SyrNitram/recon-ground-drone/images/app-control.gif

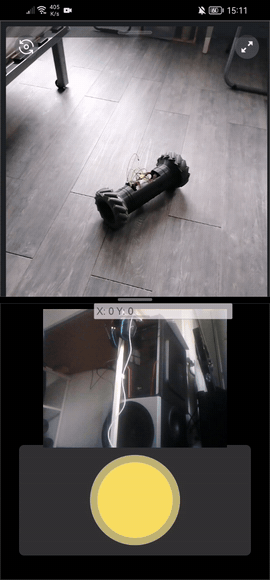
images/app-control.gif
