SyrNitram/recon-ground-drone/images/hero-lit.jpg

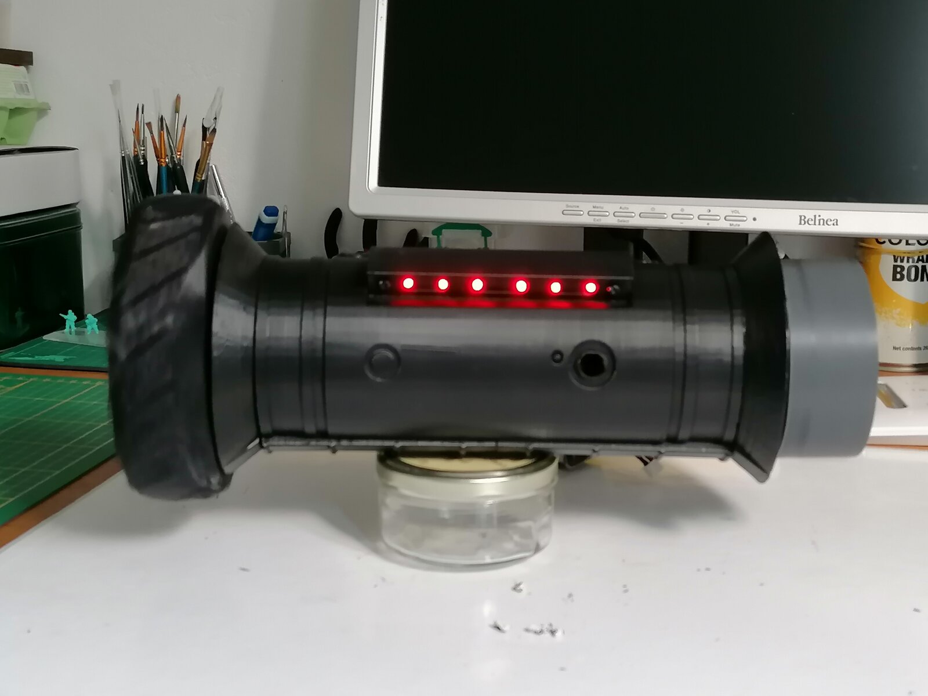
images/hero-lit.jpg
