SyrNitram/recon-ground-drone/hardware/BOM.xlsx

Sheet: BOM_bat+ch
Mecanique | Réference | Prix unitaire | Qté | Prix total | Prix commande | Delais de livraison | Liens
PLA | ICE Filaments PLA filament, 1.75mm, 0.75 kg Brave Black | 16.94 | 2 | 33.88 | 33.88 | 3 | https://amzn.eu/d/2PTAt4H
TPU | SUNLU TPU Filament 1.75 mm, 0.5kg Black | 19.99 | 1 | 19.99 | 19.99 | 3 | https://amzn.eu/d/gMaCLZG
kit vis | 230 Pièces M2 Vis à Tête Hexagonale en Acier Inoxydable | 12 | 0.5 | 6 | 12 | 4 | https://amzn.eu/d/2nECZO1
roulement à bille | 10pcs Roulements à Billes Roulements (8x16x5mm) | 8.99 | 0.2 | 1.798 | 8.99 | 3 | https://amzn.eu/d/efW1nxD | https://www.aliexpress.com/item/1005004120192357.html
ressort | 20pcs 0.4mm 3mm 50mm ressort | 2.02 | 0.05 | 0.101 | 2.02 | 60 | https://www.aliexpress.com/item/1005001408323096.html?curPageLogUid=bRA3kIthAXiv
Total robot Meca |  |  |  | 61.769
Total commande Meca |  |  |  |  | 76.88
Electronique
Moteurs | Moto-reducteur 12v 130RPM | 8.16 | 2 | 16.32 | 16.32 | 30 | https://fr.aliexpress.com/item/1005003500998134.html
L298N | 5 Pièces L298N Carte contrôleur | 13.79 | 0.2 | 2.758 | 13.79 | 3 | https://amzn.eu/d/0nnKbMM
ESP32-cam | ESP32 Carte de Développement +OV2640 + antenne 2,4GHz | 14.96 | 1 | 14.96 | 14.96 | 3 | https://amzn.eu/d/3P0Oj14
GPIO-expander | ZkeeShop 6Pcs PCF8574 IO Expansion Board I2C Interface | 11.99 | 0.1666666667 | 1.998333333 | 11.99 | 4 | https://amzn.eu/d/fPdxQ3Y
Led rouge ou bleu | 50pcs F3 3MM Round Clear / Fog Two Color Common Anode | 2.28 | 0.12 | 0.2736 | 2.28 | 5 | https://www.aliexpress.com/item/1005003764996533.html?spm=a2g0o.cart.0.0.213438daeBNRyS&mp=1
kit Gaine thermo + cable+connecteur+resistance | Made in Maison | 15 | 1 | 15 | 15 | na
Batterie | TATTU 1300 mAh 11.1 V 75C 3S1P LiPo XT60 | 16.99 | 1 | 16.99 | 16.99 | 15 | https://amzn.eu/d/0NoKHRE
Chargeur | ICQUANZX Chargeur d'équilibre de Batterie au Lithium, B3 Pro 2S-3S | 11.99 | 1 | 11.99 | 11.99 | 4 | https://amzn.eu/d/6dby1jH
Bouton | 10Pcs Latching Self-locking Push button | 2.45 | 0.1 | 0.245 | 2.45 | 3 | https://www.aliexpress.com/item/32691250472.html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
Total robot Elec |  |  |  | 80.53493333
Total commande Elec |  |  |  |  | 105.77
Total robot |  |  |  | 142.3039333
Total commande |  |  |  |  | 182.65

Sheet: BOM_bat
Mecanique | Réference | Prix unitaire | Qté | Prix total | Prix commande | Delais de livraison | Liens
PLA | ICE Filaments PLA filament, 1.75mm, 0.75 kg Brave Black | 16.94 | 2 | 33.88 | 33.88 | 3 | https://amzn.eu/d/2PTAt4H
TPU | SUNLU TPU Filament 1.75 mm, 0.5kg Black | 19.99 | 1 | 19.99 | 19.99 | 3 | https://amzn.eu/d/gMaCLZG
kit vis | 230 Pièces M2 Vis à Tête Hexagonale en Acier Inoxydable | 12 | 0.5 | 6 | 12 | 4 | https://amzn.eu/d/2nECZO1
roulement à bille | 10pcs Roulements à Billes Roulements 6001-2RS (12x28x8mm) | 21.39 | 0.2 | 4.278 | 21.39 | 3 | https://amzn.eu/d/4jeZSVb
Total robot Meca |  |  |  | 64.148
Total commande Meca |  |  |  |  | 87.26
Electronique
Moteurs | Moto-reducteur 12v 130RPM | 8.16 | 2 | 16.32 | 16.32 | 30 | https://fr.aliexpress.com/item/1005003500998134.html
L298N | 5 Pièces L298N Carte contrôleur | 13.79 | 0.2 | 2.758 | 13.79 | 3 | https://amzn.eu/d/0nnKbMM
ESP32-cam | ESP32 Carte de Développement +OV2640 + antenne 2,4GHz | 14.96 | 1 | 14.96 | 14.96 | 3 | https://amzn.eu/d/3P0Oj14
GPIO-expander | ZkeeShop 6Pcs PCF8574 IO Expansion Board I2C Interface | 11.99 | 0.1666666667 | 1.998333333 | 11.99 | 4 | https://amzn.eu/d/fPdxQ3Y
Servo-moteur | 5 Pièces Longruner SG90 Mini Servo Moteur 9g | 15.99 | 0.2 | 3.198 | 15.99 | 3 | https://amzn.eu/d/j3UOdCJ
Led rouge ou bleu | AUKENIEN 500 Pièces 3MM Diode LED Kit D'assortiment (200 utiles) | 9.99 | 0.03 | 0.2997 | 9.99 | 5 | https://amzn.eu/d/gkMQvUh
Resitance | Résistances carbone 150 Ohms 1/4 Watts +/- 5% (50) | 3.7 | 0.12 | 0.444 | 3.7 | 5 | https://amzn.eu/d/aoKDxQv
kit Gaine thermo + cable+connecteur | Made in Maison | 15 | 1 | 15 | 15 | na
Batterie | TATTU 1550 mAh 11.1 V 45C 3S1P LiPo XT60 | 15.99 | 1 | 15.99 | 15.99 | 15 | https://amzn.eu/d/iXAa5Lm
Chargeur | ICQUANZX Chargeur d'équilibre de Batterie au Lithium, B3 Pro 2S-3S | 11.99 | 0 | 0 | 0 | 4 | https://amzn.eu/d/6dby1jH
alarme lipo | 5Pack Testeur de batterie basse tension Youmile 1-8S | 16.29 | 0.2 | 3.258 | 16.29 | 3 | https://amzn.eu/d/8aOpBTQ
Total robot Elec |  |  |  | 74.22603333
Total commande Elec |  |  |  |  | 134.02
Total robot |  |  |  | 138.3740333
Total commande |  |  |  |  | 221.28

Sheet: BOM
Mecanique | Réference | Prix unitaire | Qté | Prix total | Prix commande | Delais de livraison | Liens
PLA | ICE Filaments PLA filament, 1.75mm, 0.75 kg Brave Black | 16.94 | 2 | 33.88 | 33.88 | 3 | https://amzn.eu/d/2PTAt4H
TPU | SUNLU TPU Filament 1.75 mm, 0.5kg Black | 19.99 | 1 | 19.99 | 19.99 | 3 | https://amzn.eu/d/gMaCLZG
kit vis | 230 Pièces M2 Vis à Tête Hexagonale en Acier Inoxydable | 12 | 0.5 | 6 | 12 | 4 | https://amzn.eu/d/2nECZO1
roulement à bille | 10pcs Roulements à Billes Roulements 6001-2RS (12x28x8mm) | 21.39 | 0.2 | 4.278 | 21.39 | 3 | https://amzn.eu/d/4jeZSVb
Total robot Meca |  |  |  | 64.148
Total commande Meca |  |  |  |  | 87.26
Electronique
Moteurs | Moto-reducteur 12v 130RPM | 8.16 | 2 | 16.32 | 16.32 | 30 | https://fr.aliexpress.com/item/1005003500998134.html
L298N | 5 Pièces L298N Carte contrôleur | 13.79 | 0.2 | 2.758 | 13.79 | 3 | https://amzn.eu/d/0nnKbMM
ESP32-cam | ESP32 Carte de Développement +OV2640 + antenne 2,4GHz | 14.96 | 1 | 14.96 | 14.96 | 3 | https://amzn.eu/d/3P0Oj14
GPIO-expander | ZkeeShop 6Pcs PCF8574 IO Expansion Board I2C Interface | 11.99 | 0.1666666667 | 1.998333333 | 11.99 | 4 | https://amzn.eu/d/fPdxQ3Y
Servo-moteur | 5 Pièces Longruner SG90 Mini Servo Moteur 9g | 15.99 | 0.2 | 3.198 | 15.99 | 3 | https://amzn.eu/d/j3UOdCJ
Led rouge ou bleu | AUKENIEN 500 Pièces 3MM Diode LED Kit D'assortiment (200 utiles) | 9.99 | 0.03 | 0.2997 | 9.99 | 5 | https://amzn.eu/d/gkMQvUh
Resitance | Résistances carbone 150 Ohms 1/4 Watts +/- 5% (50) | 3.7 | 0.12 | 0.444 | 3.7 | 5 | https://amzn.eu/d/aoKDxQv
kit Gaine thermo + cable+connecteur | Made in Maison | 15 | 1 | 15 | 15 | na
Batterie | TATTU 1550 mAh 11.1 V 45C 3S1P LiPo XT60 | 15.99 | 0 | 0 | 0 | 15 | https://amzn.eu/d/iXAa5Lm
Chargeur | ICQUANZX Chargeur d'équilibre de Batterie au Lithium, B3 Pro 2S-3S | 11.99 | 0 | 0 | 0 | 4 | https://amzn.eu/d/6dby1jH
alarme lipo | 5Pack Testeur de batterie basse tension Youmile 1-8S | 16.29 | 0 | 0 | 0 | 3 | https://amzn.eu/d/8aOpBTQ
Total robot Elec |  |  |  | 54.97803333
Total commande Elec |  |  |  |  | 101.74
Total robot |  |  |  | 119.1260333
Total commande |  |  |  |  | 189

Sheet: Marge
Prix de vente de base | Marge robot | Prix base + opt bat | Marge bat | Prix base + opt bat et charg | Marge bat et charg
200 | 80 | 225 | 85.74 | 250 | 98.74
250 | 130 | 275 | 135.74 | 300 | 148.74
300 | 180 | 325 | 185.74 | 350 | 198.74
350 | 230 | 375 | 235.74 | 400 | 248.74
400 | 280 | 425 | 285.74 | 450 | 298.74
Prix opt batterie | 25 |  | Marge batterie | 5.74
Prix option chargeur | 25 |  | Marge chargeur | 13
Prix materiel base | 120
Prix bat | 16
Prix charg | 12
Prix alarme | 3.26
OPT batterie | inclus batterie et alarme lipo
OPT batterie + chargeur | inclus batterie, alarme lipo et chargeur
Temps impression 3d + temps fabrication |  | 230
Prix materiel base |  | 120
Cout total base |  | 350
