SyrNitram/recon-ground-drone/test-sketches/Test_cam2/Test_cam2.ino

// Recon Ground Drone - adapted file
// Original code (c) 2022-2023 Martin RYS, released under the MIT License.
// Adapted from: un0038998 / CameraCarWithPanTiltControl (MIT) and robotzero.one (see THIRD_PARTY.md).

//L298N ON ESP32 CAM
//https://www.youtube.com/watch?v=tyY7AN132Xs
//https://www.youtube.com/watch?v=tyY7AN132Xs
//https://github.com/un0038998/CameraCarWithPanTiltControl
//https://github.com/un0038998/CameraCarWithPanTiltControl

//PWM
//https://electroniqueamateur.blogspot.com/2019/08/modulation-par-largeur-dimpulsion-pwm.html
//https://electroniqueamateur.blogspot.com/2019/08/modulation-par-largeur-dimpulsion-pwm.html
//https://gist.github.com/benpeoples/3aa57bffc0f26ede6623ca520f26628c

//WEBSERVER AND HTML
//https://robotzero.one/esp32-cam-rc-car/
//https://robotzero.one/esp32-cam-rc-car/
//https://robotzero.one/esp32-cam-rc-car/
//DECODE HTML : https://gchq.github.io/CyberChef/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
//ENCODE HTML : https://gchq.github.io/CyberChef/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

#include <ArduinoWebsockets.h>
#include <WiFi.h>
#include <ESPAsyncWebServer.h>
#include "esp_camera.h"
 
const char* ssid = "YOUR_WIFI_SSID"; //Enter SSID
const char* password = "YOUR_WIFI_PASSWORD"; //Enter Password
 
const uint8_t index_html_gz[] = {0x1f,0x8b,0x08,0x08,0xf0,0xcc,0x47,0x63,0x00,0xff,0x69,0x6e,0x64,0x65,0x78,0x2e,0x68,0x74,0x6d,0x6c,0x2e,0x67,0x7a,0x00,0x9d,0x58,0x6d,0x6f,0xdb,0x38,0x12,0xfe,0xde,0x5f,0xc1,0xd5,0xe2,0x00,0xfb,0xd6,0x96,0x1c,0xa7,0xe9,0x35,0x3e,0xcb,0x05,0x7a,0x29,0xb0,0x01,0x5a,0xec,0x61,0x93,0xdb,0x36,0x38,0x1c,0x0c,0x5a,0xa2,0x6d,0xb6,0x94,0xa8,0x23,0x29,0xbf,0xdc,0xb5,0xff,0x7d,0x87,0x94,0x44,0x91,0xb2,0x9c,0x20,0xf1,0x07,0x83,0x1a,0x72,0x9e,0x19,0x0e,0xe7,0x8d,0x9c,0x6f,0x55,0xc6,0x16,0xaf,0x10,0x9a,0x6f,0x09,0x4e,0xf5,0x00,0x86,0x19,0x51,0xd8,0x8c,0x10,0xca,0x71,0x46,0xe2,0x60,0x47,0xc9,0xbe,0xe0,0x42,0x05,0x35,0x35,0xe1,0xb9,0x22,0xb9,0x8a,0x83,0x3d,0x4d,0xd5,0x36,0x4e,0xc9,0x8e,0x26,0x64,0x6c,0x3e,0x46,0xd5,0x0a,0xf8,0xd1,0x9c,0x2a,0x8a,0xd9,0x58,0x26,0x98,0x91,0xf8,0x22,0x9c,0xb4,0x53,0xa5,0x24,0xc2,0xd0,0xf1,0x0a,0xa6,0x72,0x5e,0xe1,0x46,0xb5,0x78,0x45,0x15,0x23,0x8b,0xdf,0xdf,0x8c,0x6f,0x04,0xcf,0x09,0xfa,0x07,0x08,0x13,0x9c,0x31,0x22,0xe6,0x51,0x35,0x55,0x2d,0x93,0xea,0xd8,0x8c,0x11,0xfa,0x59,0xab,0x84,0x69,0x4e,0x04,0xfa,0x7f,0x4d,0x42,0x28,0xc3,0x62,0x43,0xf3,0x19,0xc2,0xa5,0xe2,0x7f,0xb7,0xd4,0x94,0xca,0x82,0xe1,0xe3,0x0c,0xad,0x18,0x4f,0xbe,0xb5,0x74,0xa3,0xfe,0x0c,0x5d,0x4f,0xfe,0xd2,0xd2,0xb6,0x84,0x6e,0xb6,0x6a,0x86,0x5e,0x4f,0x76,0xdb,0x96,0xba,0xc2,0xc9,0xb7,0x8d,0xe0,0x65,0x9e,0x8e,0x13,0xce,0xb8,0x98,0xa1,0x9f,0x2f,0x2f,0x2f,0x7b,0x24,0xac,0x19,0x39,0xb4,0x64,0xcc,0xe8,0x26,0x1f,0x53,0x45,0x32,0x39,0x43,0x09,0xd8,0x8f,0x88,0x76,0xf2,0x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
db,0xa1,0x9c,0x2f,0xa0,0x5e,0x46,0x38,0xfc,0x93,0xcb,0x11,0x3a,0x9a,0x7f,0xc2,0x5c,0xbb,0x11,0x16,0x9a,0xfb,0x7e,0xa8,0xf4,0x62,0x78,0x10,0xd2,0x77,0xb3,0xc0,0x7c,0x68,0xce,0x4b,0xc8,0x05,0x10,0xcd,0x9a,0x5f,0x47,0x77,0x71,0x18,0x99,0xe8,0xd6,0x48,0xcd,0xf7,0x64,0x68,0x2f,0xb3,0xd5,0x21,0x14,0x38,0xbf,0x21,0x1b,0x41,0x88,0x36,0x92,0x11,0x8d,0xfe,0xaa,0x1f,0x45,0x87,0x7d,0xb9,0x40,0x33,0x28,0xca,0xa0,0x78,0x59,0x0e,0x03,0x7e,0x9e,0xc3,0x18,0xc7,0x91,0x01,0x6a,0x8c,0xb4,0x4e,0x0e,0x4a,0xe7,0xe5,0x11,0xde,0x58,0xec,0x35,0x7f,0x1e,0xe9,0xb7,0x95,0xc5,0x2b,0x78,0x6c,0x31,0xaf,0xfa,0x7f,0x02,0xa4,0xc9,0x43,0x04,0xdd,0x17,0x00,0x00
};
 
#define PWDN_GPIO_NUM     32
#define RESET_GPIO_NUM    -1
#define XCLK_GPIO_NUM      0
#define SIOD_GPIO_NUM     26
#define SIOC_GPIO_NUM     27
#define Y9_GPIO_NUM       35
#define Y8_GPIO_NUM       34
#define Y7_GPIO_NUM       39
#define Y6_GPIO_NUM       36
#define Y5_GPIO_NUM       21
#define Y4_GPIO_NUM       19
#define Y3_GPIO_NUM       18
#define Y2_GPIO_NUM        5
#define VSYNC_GPIO_NUM    25
#define HREF_GPIO_NUM     23
#define PCLK_GPIO_NUM     22
 
camera_fb_t * fb = NULL;
 
using namespace websockets;
WebsocketsServer server;
AsyncWebServer webserver(80);
 
const int fwdPin = 2;  //Forward Motor Pin
const int turnPin = 12;  //Steering Servo Pin
 
// Arduino like analogWrite
// value has to be between 0 and valueMax
void fwdAnalogWrite(uint8_t channel, uint32_t value, uint32_t valueMax = 4000) {
  // calculate duty, 8191 from 2 ^ 13 - 1
  uint32_t duty = (8191 / valueMax) * min(value, valueMax);
  ledcWrite(channel, duty);
}
void steeringAnalogWrite(uint8_t channel, uint32_t value, uint32_t valueMax = 180) {
  // calculate duty, 8191 from 2 ^ 13 - 1
  uint32_t duty = (8191 / valueMax) * min(value, valueMax);
  ledcWrite(channel, duty);
}
 
void setup()
{
  Serial.begin(115200);
 
  // forward motor PWM
  ledcSetup(2, 200, 12); //channel, freq, resolution
  ledcAttachPin(fwdPin, 2); // pin, channel
 
  // steering servo PWM
  ledcSetup(4, 50, 16); //channel, freq, resolution
  ledcAttachPin(turnPin, 4); // pin, channel
 
  camera_config_t config;
  config.ledc_channel = LEDC_CHANNEL_0;
  config.ledc_timer = LEDC_TIMER_0;
  config.pin_d0 = Y2_GPIO_NUM;
  config.pin_d1 = Y3_GPIO_NUM;
  config.pin_d2 = Y4_GPIO_NUM;
  config.pin_d3 = Y5_GPIO_NUM;
  config.pin_d4 = Y6_GPIO_NUM;
  config.pin_d5 = Y7_GPIO_NUM;
  config.pin_d6 = Y8_GPIO_NUM;
  config.pin_d7 = Y9_GPIO_NUM;
  config.pin_xclk = XCLK_GPIO_NUM;
  config.pin_pclk = PCLK_GPIO_NUM;
  config.pin_vsync = VSYNC_GPIO_NUM;
  config.pin_href = HREF_GPIO_NUM;
  config.pin_sscb_sda = SIOD_GPIO_NUM;
  config.pin_sscb_scl = SIOC_GPIO_NUM;
  config.pin_pwdn = PWDN_GPIO_NUM;
  config.pin_reset = RESET_GPIO_NUM;
  config.xclk_freq_hz = 20000000;
  config.pixel_format = PIXFORMAT_JPEG;
  //init with high specs to pre-allocate larger buffers
  if (psramFound()) {
    config.frame_size = FRAMESIZE_UXGA;
    config.jpeg_quality = 10;
    config.fb_count = 2;
  } else {
    config.frame_size = FRAMESIZE_SVGA;
    config.jpeg_quality = 12;
    config.fb_count = 1;
  }
   
  // camera init
  esp_err_t err = esp_camera_init(&config);
  if (err != ESP_OK) {
    Serial.printf("Camera init failed with error 0x%x", err);
    return;
  }
 
  sensor_t * s = esp_camera_sensor_get();
  s->set_framesize(s, FRAMESIZE_SVGA);
 
  // Connect to wifi
  WiFi.begin(ssid, password);
 
  // Wait some time to connect to wifi
  for (int i = 0; i < 15 && WiFi.status() != WL_CONNECTED; i++) {
    Serial.print(".");
    delay(1000);
  }
 
  Serial.println("");
  Serial.println("WiFi connected");
  Serial.println("IP address: ");
  Serial.println(WiFi.localIP());   // You can get IP address assigned to ESP
 
  webserver.on("/", HTTP_GET, [](AsyncWebServerRequest * request) {
    AsyncWebServerResponse *response = request->beginResponse_P(200, "text/html", index_html_gz, sizeof(index_html_gz));
    response->addHeader("Content-Encoding", "gzip");
    request->send(response);
  });
 
  webserver.begin();
  server.listen(82);
  Serial.print("Is server live? ");
  Serial.println(server.available());
 
}
 
void handle_message(WebsocketsMessage msg) {
  int commaIndex = msg.data().indexOf(',');
  int steerValue = msg.data().substring(0, commaIndex).toInt();
  int forwardValue = msg.data().substring(commaIndex + 1).toInt();

  Serial.print(" t: ");
  Serial.print(millis());
  Serial.print(" |  Received -> steer : ");
  Serial.print(steerValue );
  Serial.print("   fw :  ");
  Serial.print(forwardValue );
  Serial.println(" ");
/* 
  if (steerValue > 5 ) {
    steeringAnalogWrite(4, 112);
  }
  else if (steerValue < -5 ) {
    steeringAnalogWrite(4, 65);
  }
  else {
    steeringAnalogWrite(4, 85); // center steering
  }
 
  forwardValue = map(forwardValue, 0, -90, 500, 2000);
 
  if (forwardValue > 600 ) {
    fwdAnalogWrite(2, forwardValue);
  }
  else {
    fwdAnalogWrite(2, 0); // stop
  }
  */
}
 
void loop()
{
  auto client = server.accept();
  client.onMessage(handle_message);
  while (client.available()) {
    client.poll();
        fb = esp_camera_fb_get();
        client.sendBinary((const char *)fb->buf, fb->len);
        esp_camera_fb_return(fb);
        fb = NULL;
  }
 
}
