SyrNitram/recon-ground-drone/(commit log)

2026-06-23 Première version publique
    [BOM.xlsx]
2026-06-23 Lien CAO vers la Release
